ArtEst777/Luva_VR_Versao_ESP32/(commit log)

2026-10-22 feat: estrutura completa do repositório L-UVA (Hardware, Firmware ESP32/FreeRTOS, Kalman, Docs e reserva Unity)
2026-10-22 docs: adiciona fotografias reais do protótipo L-UVA no README principal e na documentação de hardware
